craigyjp/Akai-AX-80-Display-emulation/photos/20241007_220556.jpg

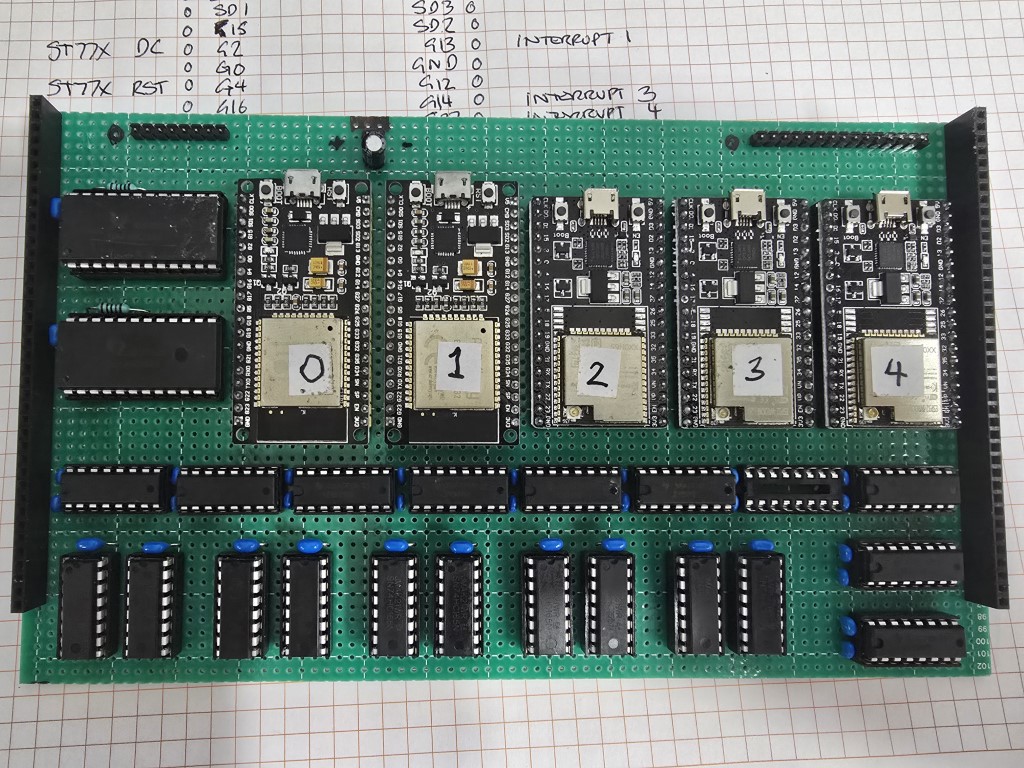
photos/20241007_220556.jpg
