craigyjp/Akai-AX-80-Display-emulation/photos/20241008_140258.jpg

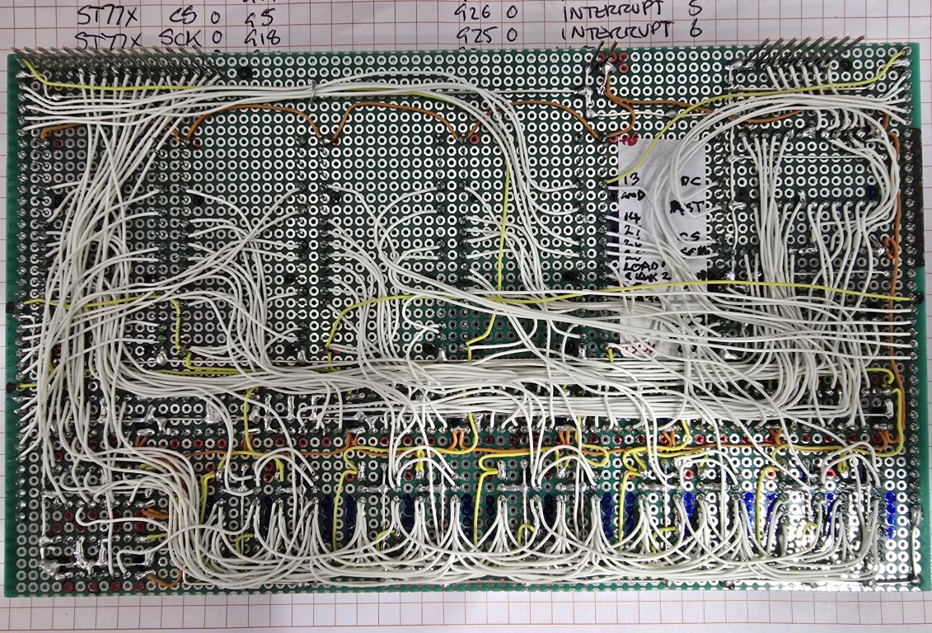
photos/20241008_140258.jpg
