craigyjp/Akai-AX-80-Display-emulation/Interface1.pdf

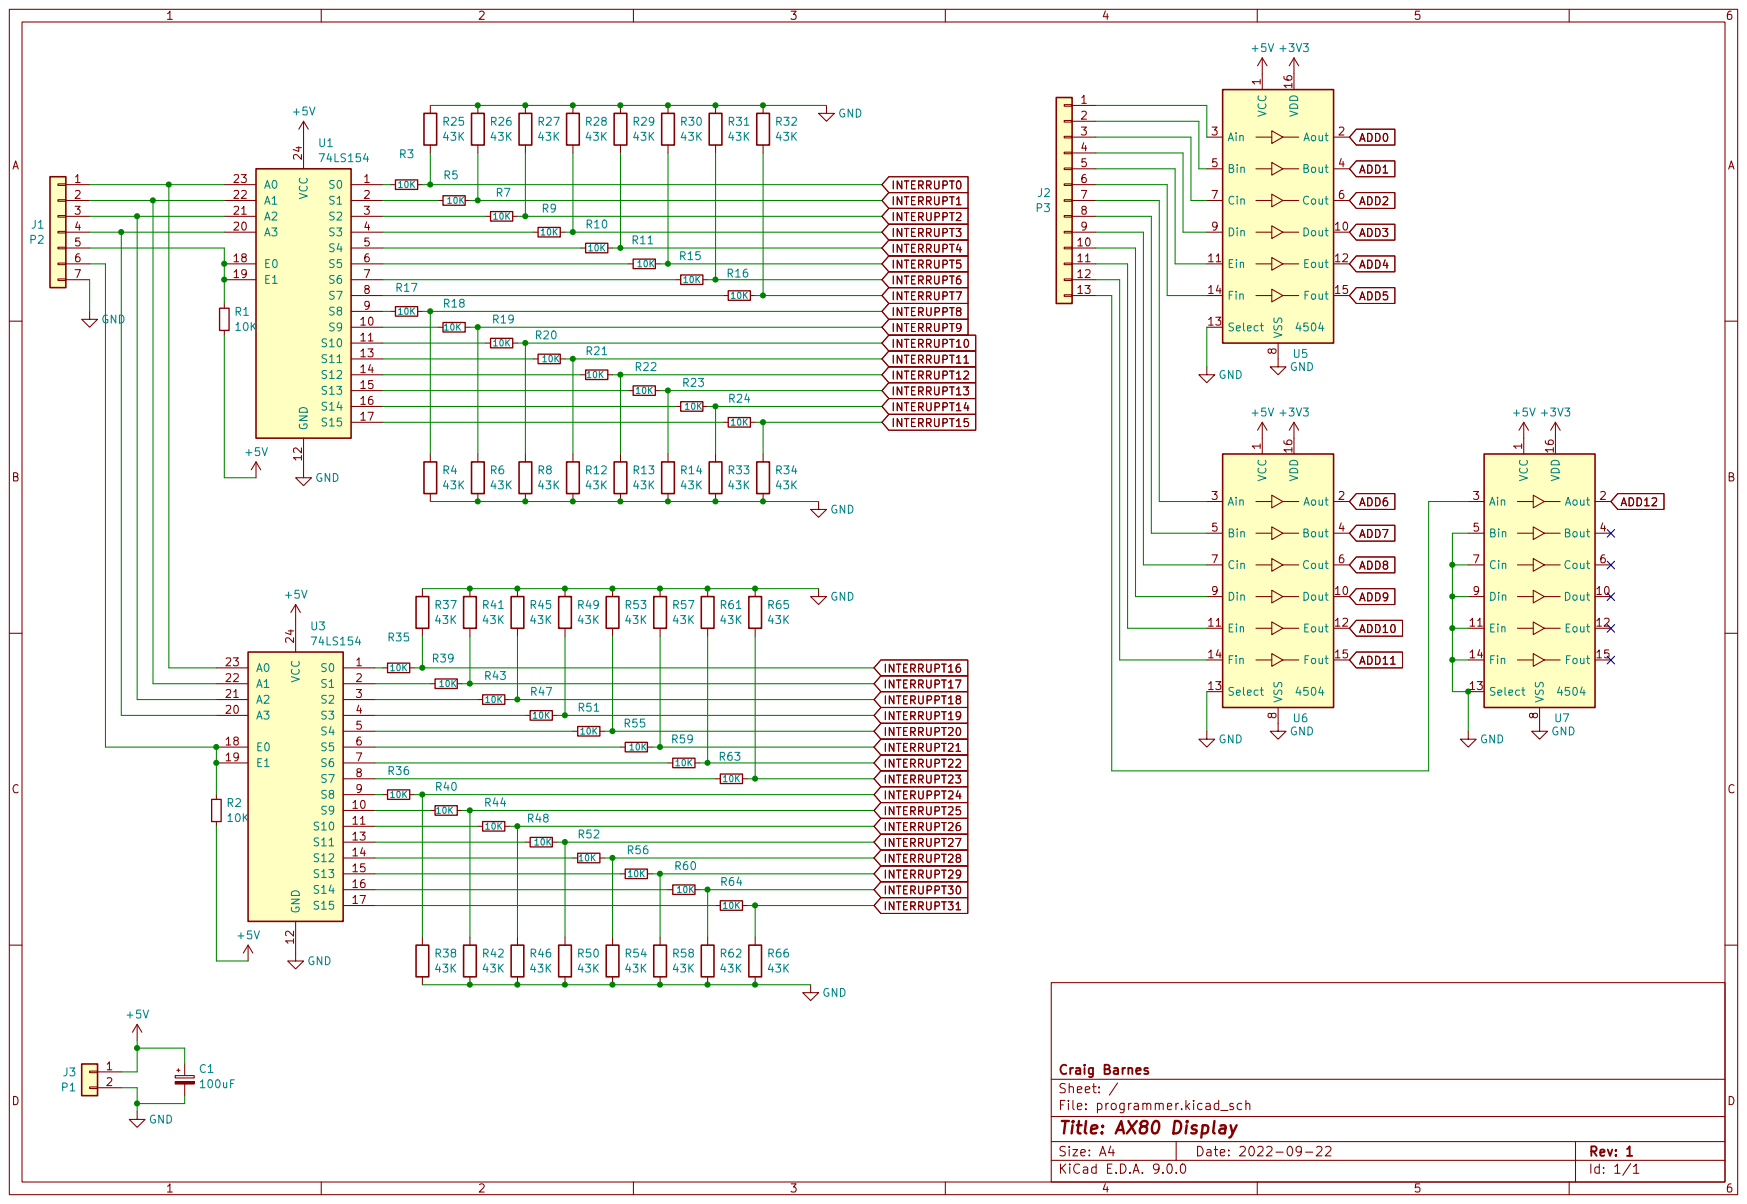
[picture p4: page 1]
