craigyjp/Akai-AX-80-Display-emulation/Interface2.pdf

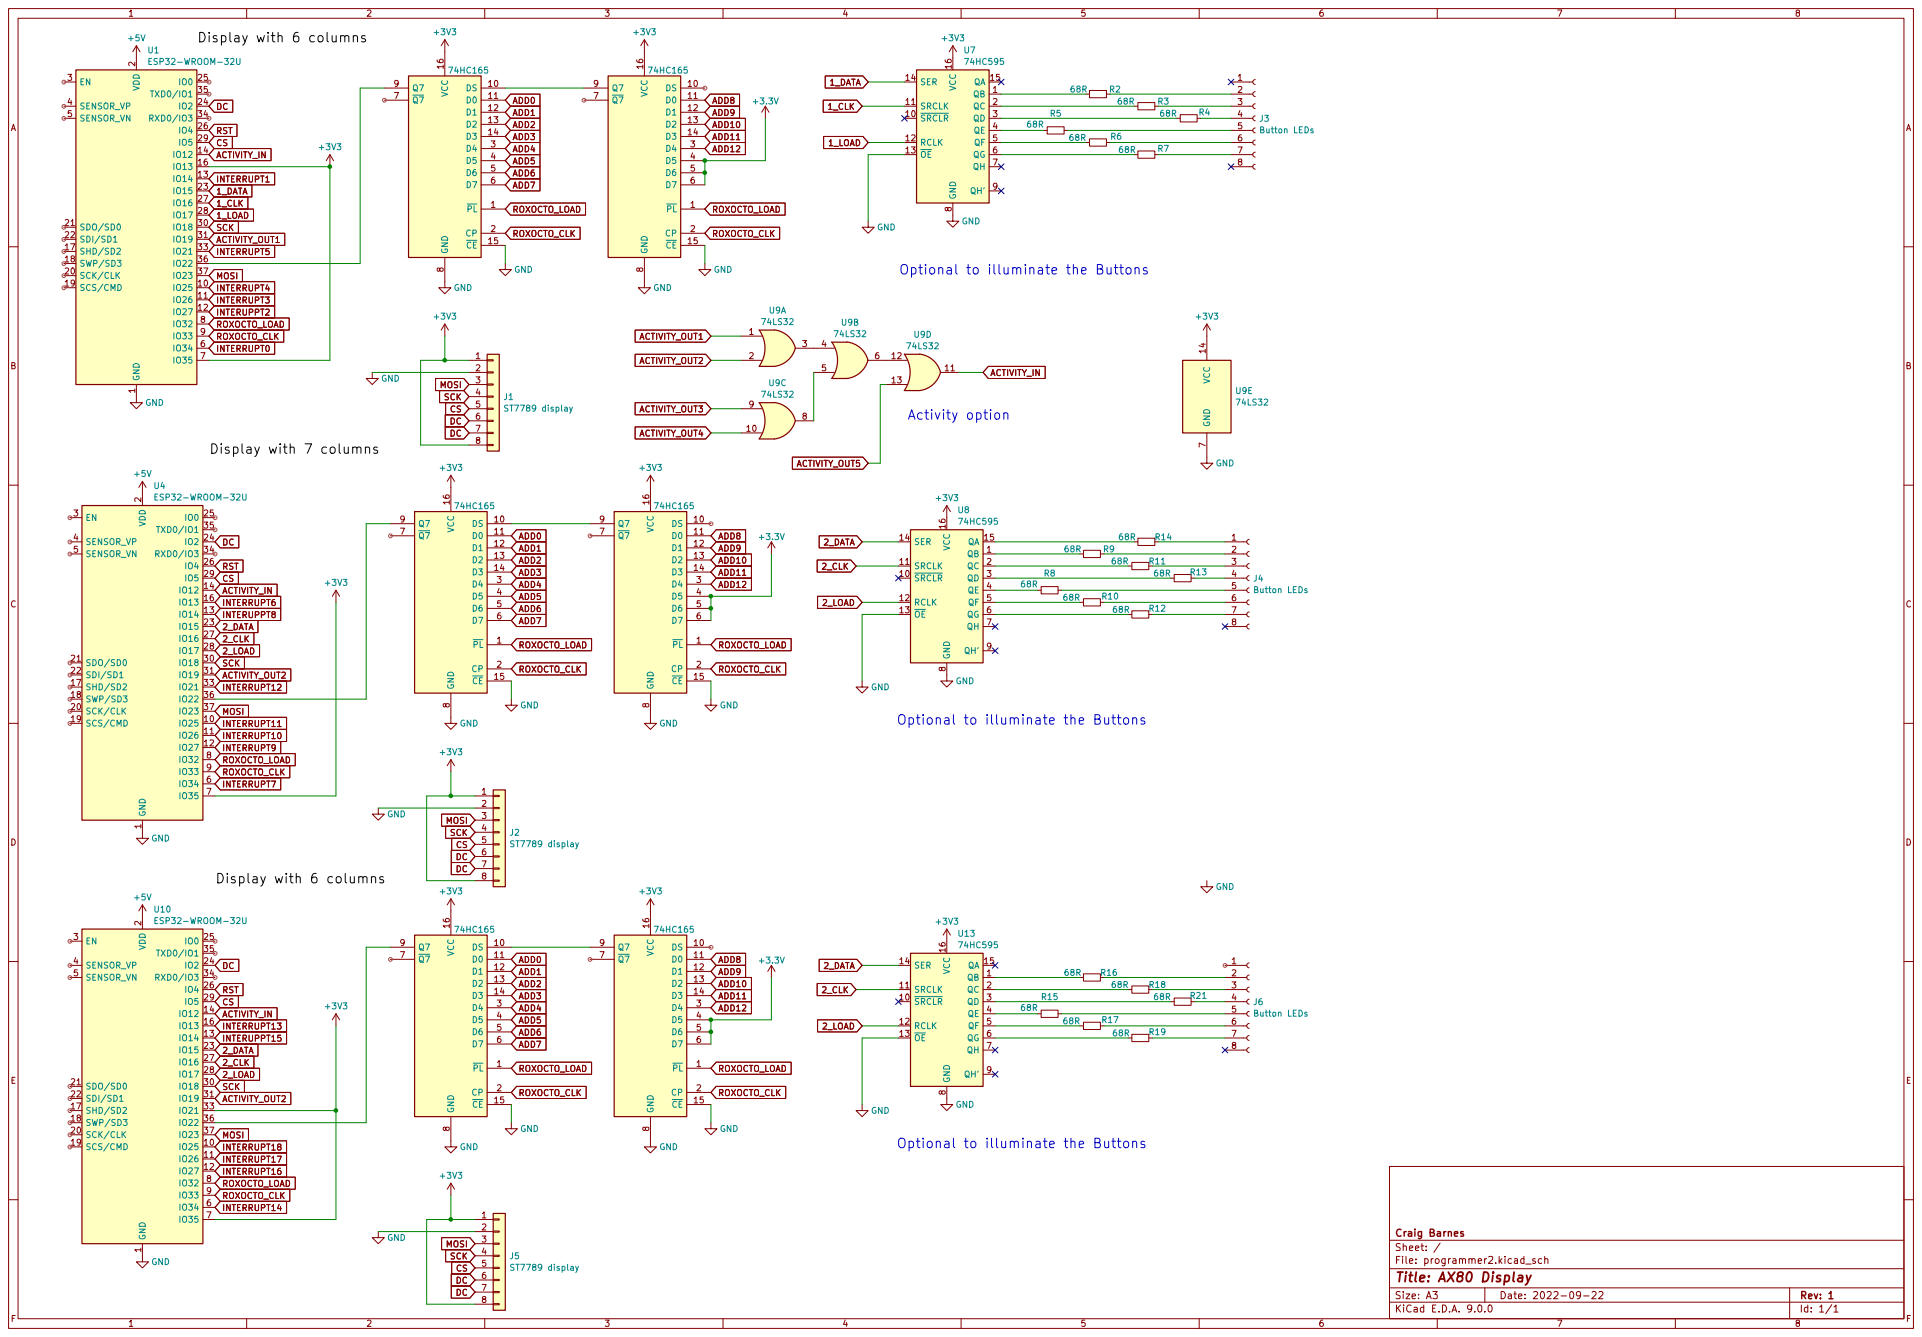
[picture p5: page 1]
