craigyjp/Akai-AX-80-Display-emulation/interface3.pdf

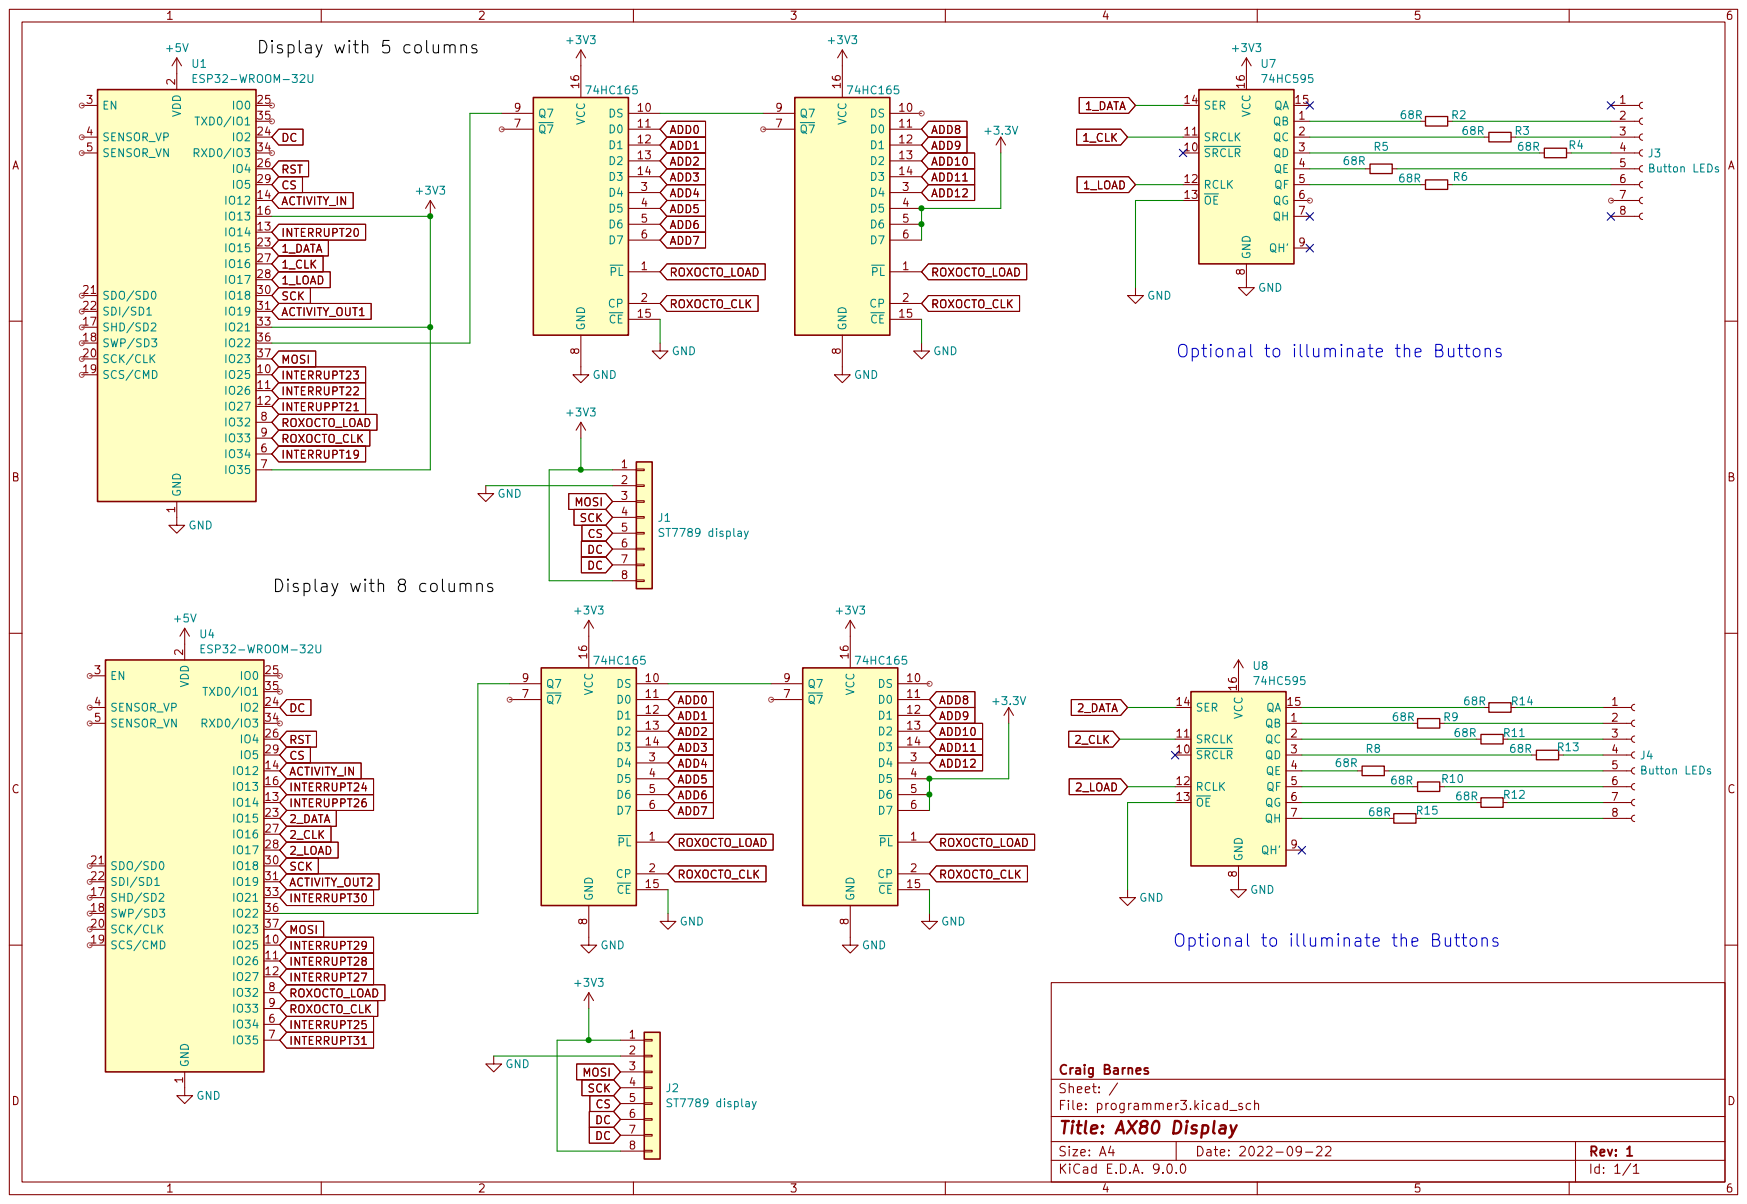
[picture p6: page 1]
