craigyjp/Akai-AX-80-Display-emulation/(commit log)

2024-10-08 Added schematics
2024-11-04 Added 595 to drive LED buttons
2024-11-04 Added 595 for LED buttons
2025-05-15 Updated schematics with button illumination
2025-06-03 Swapped level shifters for voltage dividers
